bernd-ulmann/gamma_spectrometer/arduino_adc_interface/README.md

# Arduino based ADC interface
There are quite some professional NIM analog-digital-converters out there which
can be used for hobbyist gamma spectroscopy. The only problem being how to 
interface these devices as they often feature a proprietary interface.

A few weeks ago I got a Nuclear Data ND580 ADC which in fact came from a 
gamma spectroscopy setup. After some research it turned out that many of these 
ADCs seem to use a similar parallel interface. The various data and control
lines are available at a double row pin header within the ADC module and often 
also on a 25 pin SUB-D connector. (Some systems such as the Canberra 1510 only 
feature this 25 pin connector.)

# Interface description
This is how a typical classic ADC for gamma spectroscopy looks like. The flat
ribbon cable connects to the double row pin header on the upper right and 
features a 25 pin SUB-D connector which typically connects to some memory 
unit or computer interface.
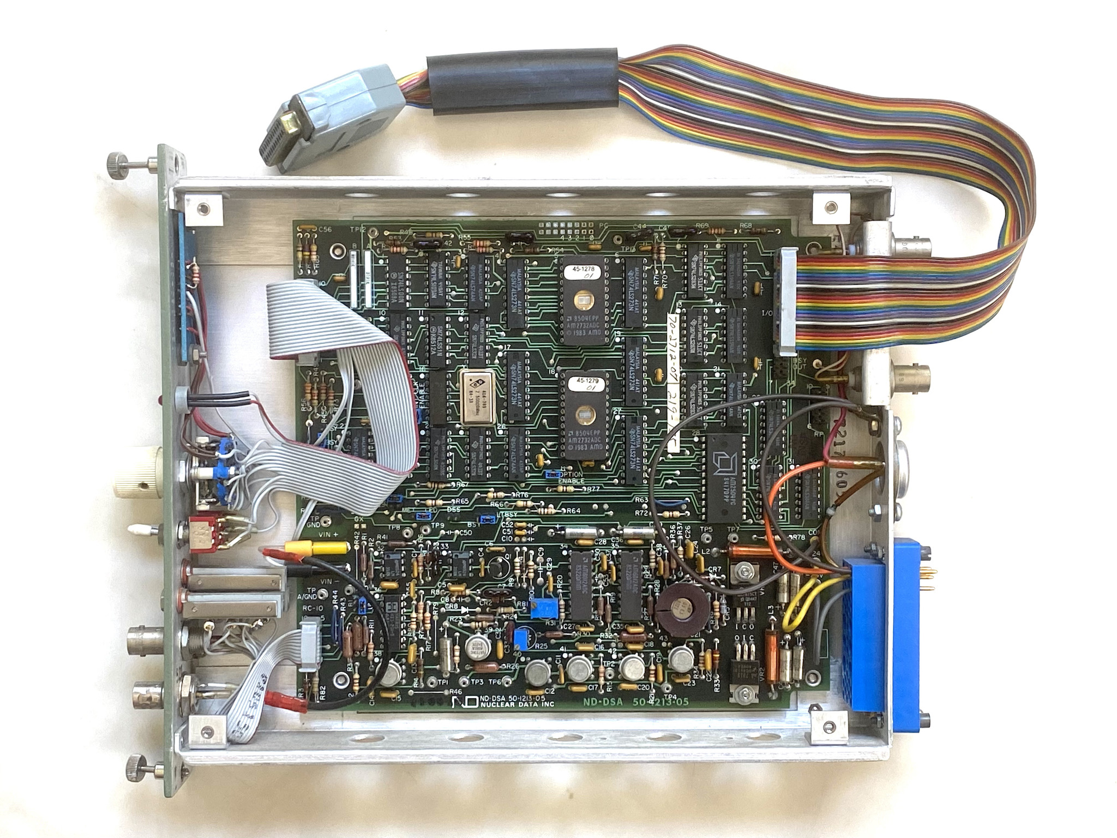
[picture p11: arduino_adc_interface/ADC.jpg]
Interface connector


Thanks to some friends I was able to deduce how this interface works. It is
quite simple, featuring up to 13 data lines (my ND580 ADC only has 4k of 
resolution and thus only drives twelve data lines) and a couple of control and 
handshake lines.

|Arduino port|Function|In/Out|SUB-D pin|Pinheader inside ADC|
|---|---|---|---|---|
|PA0 |D0* |IN |1 |14|
|PA1 |D1* |IN |2 |16|
|PA2 |D2* |IN |3 |18|
|PA3 |D3* |IN |4 |20|
|PA4 |D4* |IN |5 |22|
|PA5 |D5* |IN |6 |24|
|PA6 |D6* |IN |7 |26|
|PA7 |D7* |IN |8 |15|
|PC0 |D8* |IN |9 |17|
|PC1 |D9* |IN |10 |19|
|PC2 |D10* |IN |11 |21|
|PC3 |D11* |IN |12 |23|
|PC4 |D12* |IN |13 |25|
|PC5 |Inhibit*  |IN |20 |12|
|TXD1  |READY* |IN |14 |10|
|PB0 |ACCEPT* |OUT |17 |2|
|GND |ENABLE* | |18 |8|
|GND |OUT ENA*  | |22 |4|
|GND |GND | |24 |1, 3, 5, 7, 9, 11|

All of the interface signals are active low logic, denoted by the star behind 
the signal names. 

* D0 to D12 are the data lines from the ADC. 
* Inhibit can be set by the ADC to denote that a value should be discarded 
  (this signal is ignored in the interface described here).
* READY tells the interface that a new data words is available.
* ACCEPT tells the ADC that the data word has been read.
* ENABLE enables the ADC.
* OUT ENA enables the data lines which are otherwise in high-Z-mode (tri state).

The leftmost column in the table above lists the I/O-pins on the Arduino 
MEGA-2650 which I used in this project. Since the MEGA-2650 only has 8k bytes
of RAM of which a tiny amount is used for program variables, only 2048 channels
of a gamma spectrogram can be stored (at least at 16 bit counter resolution per
channel), so this interface only uses eleven of the twelve data lines, and the 
ADC should be set to 2k conversion gain.

# Arduino code
The C++ code [adc_readout/adc_readout.ino](adc_readout/adc_readout.ino) for the 
Arduino is quite simple and straightforward.
```
/*
    This program controls a Mega 2650 board connected to a Nuclear Data ND580 ADC.
    The purpose is to setup a simple gamma spectroscopy system consisting of old
    NIM modules and this readout module.

    Port mapping (signals marked with '*' are active low):

    IO    Function  Dir.  SUBD  Pinheader inside ADC
    ------------------------------------------------
    PA0   D0*       IN    1     14
    PA1   D1*       IN    2     16
    PA2   D2*       IN    3     18
    PA3   D3*       IN    4     20
    PA4   D4*       IN    5     22
    PA5   D5*       IN    6     24
    PA6   D6*       IN    7     26
    PA7   D7*       IN    8     15
    PC0   D8*       IN    9     17
    PC1   D9*       IN    10    19
    PC2   D10*      IN    11    21
    PC3   D11*      IN    12    23
    PC4   D12*      IN    13    25
    PC5   Inhibit*  IN    20    12
    TXD1  READY*    IN    14    10
    PB0   ACCEPT*   OUT   17    2
    GND   ENABLE*         18    8
    GND   OUT ENA*        22    4
    GND   GND             24    1, 3, 5, 7, 9, 11

    05-APR-2022 B. Ulmann Initial implementation
    08-APR-2022 B. Ulmann Added maximum output in 'c'-command
    03-SEP-2023 B. Ulmann Added X/Y-output for an oscilloscope
    29-SEP-2024 B. Ulmann Added #define to reverse x-deflection voltage.
                          This became necessary since the "new" Telequipment
                          oscilloscope has a weird EXT-X input.
*/

#define BAUD_RATE 115200
#define READY_PIN 18
#define INT_MODE  FALLING
#define ADC_BITS  11        // 2k resolution - we don't have enough RAM for 12 bits resolution :-(

#define X_PIN 13            // PWM outputs for X and Y oscilloscope inputs.
#define Y_PIN 4
#define PIXEL_DELAY 80      // Delay after plotting a pixel to get a more stable display.
#define REVERSE_X TRUE

/*  The X/Y display requires two RC combinations connected to pins 13 and 4 of the 
 * MEGA 2650 board. 4k7 and 100 nF are suggested to get a relatively stable display
 */

union {
  byte raw[2];
  uint16_t value;
} data;

uint16_t counters[1 << ADC_BITS];
uint32_t events = 0, maximum = 0;

void get_data() {
  byte low_byte, high_byte;
  
  detachInterrupt(digitalPinToInterrupt(READY_PIN));

  data.raw[0] = PINA;
  data.raw[1] = PINC & B00111111;

  uint16_t address = ~data.value & 0x0FFF;

  if (counters[address] != 65535)
    if (++counters[address] > maximum)
      maximum = counters[address];

  events++;

  if (!(events % 10000))  // Print a dot every 10000 values to show its alive
    Serial.print(".");
  
  PORTB = B00000000;  // Flip ACCEPT*
  PORTB = B00000001;

  attachInterrupt(digitalPinToInterrupt(READY_PIN), get_data, INT_MODE);
}

void setup() {
  DDRA = B00000000;   // Lower eight bits
  DDRB = B00000001;   // PB0 is an output
  DDRC = B00000000;   // Upper five bits + inhibit

  PORTB = B00000001;  // Deactivate ACCEPT*

  Serial.begin(BAUD_RATE);

  pinMode(X_PIN, OUTPUT);
  pinMode(Y_PIN, OUTPUT);
  TCCR0B = (TCCR0B & 0b11111000) | 0x01;  // No clock divider for timer 0 to get a high PWM frequency

  attachInterrupt(digitalPinToInterrupt(READY_PIN), get_data, INT_MODE);

  Serial.print("INIT...\n");
}

void loop() {
  unsigned int x = 0, y_scale = 0;

  for (;;) {
#ifdef REVERSE_X
    analogWrite(X_PIN, 255 - x);
#else
    analogWrite(X_PIN, x);
#endif
    analogWrite(Y_PIN, counters[x++ << 3] >> y_scale);

    delayMicroseconds(PIXEL_DELAY);
    if (x == 256) {
      x = 0;
      analogWrite(X_PIN, x);

      delayMicroseconds(1000);  // Wait pretty long for the beam to get back to the lower left corner.

      int flag = 0;             // Do we need to rescale the display?
      for (unsigned int i = 0; i < 256; i++)
        if ((counters[i << 3] >> y_scale) > 255)
          flag = 1;

      if (flag) y_scale++;      // Scale by another factor of 2.
    }

    if (Serial.available() > 0) {
      switch(Serial.read()) {
        case 'c': // Read counter
          detachInterrupt(digitalPinToInterrupt(READY_PIN));
          Serial.print("Events = " + String(events) + ", maximum value = " + String(maximum) + "\n");
          attachInterrupt(digitalPinToInterrupt(READY_PIN), get_data, INT_MODE);
          break;
        case 'r': // Readout
          detachInterrupt(digitalPinToInterrupt(READY_PIN));
          Serial.print("--------\n");
          for (uint16_t i = 0; i < (1 << ADC_BITS); Serial.print(String(counters[i++]) + "\n"));
          Serial.print("--------\n");
          attachInterrupt(digitalPinToInterrupt(READY_PIN), get_data, INT_MODE);
          break;
        case 'x': // Reset
          detachInterrupt(digitalPinToInterrupt(READY_PIN));
          events = maximum = y_scale = 0;
          for (uint16_t i = 0; i < (1 << ADC_BITS); counters[i++] = 0);
          Serial.print("Reset\n");
          attachInterrupt(digitalPinToInterrupt(READY_PIN), get_data, INT_MODE);
          break;        
      }
    }
  }
}
```

At the heart of the software is the interrupt routine get_data() which is 
called whenever the READY line has a falling edge. It reads an eleven bit 
data word into a union which effectively combines the two parts of this word
into a single 16 bit value, the channel number. It then increments the 
respective channel counter. It also counts the overall number of events 
detected to far and the maximum count number of all channels.

This little program communicates with an attached computer by means of the 
builtin USB interface employing a serial-line emulation. Three commands are
supported: 

* c: Return the number of overall events counted so far as well as the maximum
     peak in all channels.
* r: Read data from the 2048 channels. Data is returned as 2048 lines each 
     containing the number of events in a channel in decimal representation.
* x: Reset the device, i.e. clear all channel counters etc.

By default Arduinos perform a reset when a new serial line connection is 
established, which is quite undesirable in an application like this with 
long measurement times. It is advisable to cut the "reset" bridge on the 
Arduino board (see documentation for the MEGA-2650). Since this reset feature
is important for the programmability of the Arduino, a switch should be 
connected to this cut bridge connection (this is the switch labelled "run/prg").

The following pictures show the exterior of the interface and its construction:
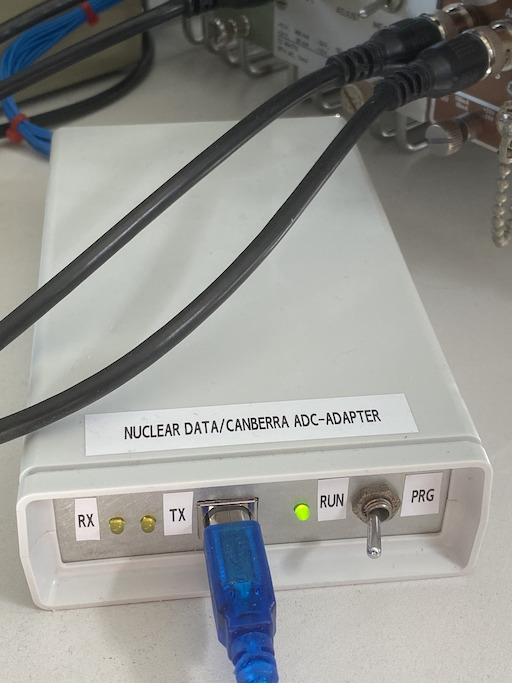
[picture p12: arduino_adc_interface/interface.jpg]
Interface

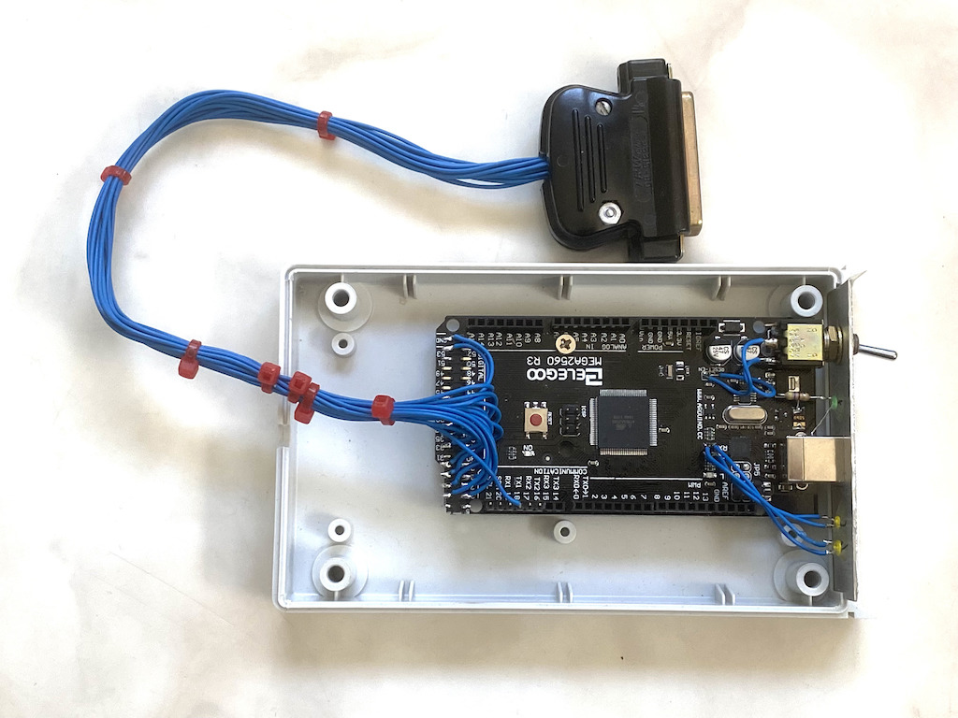
[picture p13: arduino_adc_interface/interior_view.jpg]
Interior view


# Readout and display software
Although it is possible and feasible to use this interface manually using the
serial monitor which is part of the Arduino IDE, copying the channel counts 
into a file and then using gnuplot or a similar tool to display the data, it
is more convenient to use a little tool written in Perl to communicate with 
the ADC interface: [adcread.pl](adcread.pl)

```
#
#  This simple Perl program either reads raw data from the Arduino based ADC
# adapter which works with Nuclear Data ADCs such as the ND580 or with 
# similar Canberra devices like the Canberra 1510.
#
#  This program can perform a number of actions as described in the help 
# message below.
#
#  Data is displayed using gnuplot. The plot is not normalized with respect to
# its x- and y-axes, so that energy calibration must be done using the -e 
# parameter. 
#
# 2022-04-09    B. Ulmann   Initial version based on the old Perl program 
#                           targeted at the homebrew simple Gamma spectrometer.
# 2022-04-13    B. Ulmann   Added keV-scaling.
# 2023-03-19    B. Ulmann   Added JPG output
# 2026-07-25    B. Ulmann   Added denser xtics and log scale
#

use strict;
use warnings;
use File::Temp;
use Getopt::Long qw(GetOptions);
use Device::SerialPort;
use Time::HiRes qw(usleep);
use POSIX qw(strftime);

my $baudrate = 115200;
my $channels = 2048;

die "Usage: perl $0 {-u <usb_port> | -f <filename>} 
                    [-w <window_size>] 
                    [-f <filename>] Reads data from a file
                    [-e <energy of last channel]
                    [-d <destination_filename>] Timestamp by default
                    [-t <title>]
                    [-l] set y axis to log scale
                    [-p] generate a plot
                    [-j] do not plot but create a jpg picture
                    [-a] alpha spectrum (different parameters)
                    [-y <value>] set y-range
       perl $0 -r (to reset the device)
       perl $0 -s (to get statistics)\n" 
    unless @ARGV;

my ($usb_port, $window_size, $filename, $destination, $statistics, $reset, 
    $title, $jpg, $plot, $yrange, $alpha, $logscale, $energy);
$title = '';
GetOptions('u=s' => \$usb_port, 
           'w=s' => \$window_size, 
           'f=s' => \$filename, 
           'd=s' => \$destination, 
           's'   => \$statistics, 
           'r'   => \$reset,
           'j'   => \$jpg,
           'p'   => \$plot,
           'a'   => \$alpha,
           'l'   => \$logscale,
           'e=s' => \$energy,
           'y=s' => \$yrange,
           't=s' => \$title);

die "Either -f or -u must be specified!\n" if !defined($filename) and !defined($usb_port);
die "-f and -u are mutually exclusive!\n"  if  defined($filename) and  defined($usb_port);

my $port;
if (defined($usb_port)) {
    $port = Device::SerialPort->new($usb_port) or die "Unable to open USB-port: $!\n";
    $port->baudrate($baudrate);
    $port->databits(8);
    $port->parity('none');
    $port->stopbits(1);
}

my $date = strftime("%Y%m%d-%H%M%S", localtime);
$title |= "$date";
$title = $filename if defined($filename);

if ($reset) {
    die "Reset requires a USB port to be specified!\n" unless defined($port);
    $port->write('x');  # Send reset command
    sleep(1);
    my $response = $port->lookfor();
    die "Illegal response from device: >>$response<<\n" unless $response =~ ".*Reset";
    print "Device has been reset.\n";
} elsif ($statistics) {
    die "Statistics requires a USB port to be specified!\n" unless defined($port);
    $port->write('c');  # Send reset command
    sleep(1);
    my $response = $port->lookfor();
    print "$response\n";
} else {
    my @data;
    if (defined($filename)) {
        open (my $handle, '<', $filename) or die "Could not open $filename: $!\n";
        while (my $record = <$handle>) {
            chomp($record);
            push(@data, $record) if $record =~ /^\d+$/;
        }
        close($handle);
    } else {
        print "Read data...\n";
        $port->write('r');  # Issue 'read' command to gamma spectrometer
        sleep(1);

        my $state = 0;
        for my $i (0 .. 3000) {
            usleep(100);
            my $response = $port->lookfor();
            last       if $response =~ /-+/ and $state == 1; # End of data area found
            $state = 1 if $response =~ /-+/ and $state == 0; # Start of data area found

            push(@data, $response) if $response =~ /^\d+/;
        }
    }
    print scalar(@data), " records read.\n";

    my $handle;
    unless (defined($filename)) {
        $destination //= "$date.dat";
        print "Saving raw data to $destination.\n";
        open($handle, '>', $destination) or die "Could not open $destination: $!\n";
        print $handle "$_\n" for @data;
        close($handle);
    }

    if ($plot or $jpg) {
        my ($counts, @smoothed);
        if (defined($window_size)) {
            print "Smoothing with window size $window_size.\n";
            my @window;
            push(@window, shift(@data)) for (1 .. $window_size);
            $counts += $_ for @window;
            for my $i (0 .. @data - 1) {
                my $average;
                $average += $_ for @window;
                push(@smoothed, $average / $window_size);
                shift(@window);
                $counts += $data[$i];
                push(@window, $data[$i]);
            }
        } else {
            @smoothed = @data;
            $counts += $_ for @data;
            print "No smoothing applied.\n";
        }
        print "$counts events detected.\n";

        my ($increment, $x_label, $x_range);
        if (!defined($energy)) {
            $x_label = 'Channel #';
            $increment = 1;
            $x_range = $channels;
        } else {
            $increment = $energy / $channels;
            $x_label = 'Energy [keV]';
            $x_range = $energy;
        }

        $handle = File::Temp->new();
        my $tempfile = $handle->filename();
        my $x = 0;
        print $handle $x += $increment, " $_\n" for @smoothed;
        close($handle);

        my $command;
        my $y = $yrange   ? "set yrange [0:$yrange]; " : '';
        my $l = $logscale ? 'set logscale y 10; '      : '';
        
        # If the gnuplot command ends with '-' gnuplot will not be terminated 
        # after generating the plot.

        if ($jpg) {
            $command = qq(gnuplot -e "set terminal jpeg; set output '$date.jpg'; $y set xrange [0:$x_range]; set title '$title'; set xlabel '$x_label'; set ylabel 'Counts'; set xtics 0, 100; set xtics rotate by 90; $l plot '$tempfile' notitle w l");
        } else {
            $command = qq(gnuplot -e "$y set xrange [0:$x_range]; set title '$title'; set xlabel '$x_label'; set ylabel 'Counts'; set xtics 0, 100; set xtics rotate by 90; $l plot '$tempfile' notitle w l");
        }
        system($command);
    }
}
```

# Setup and usage
This was my first setup:
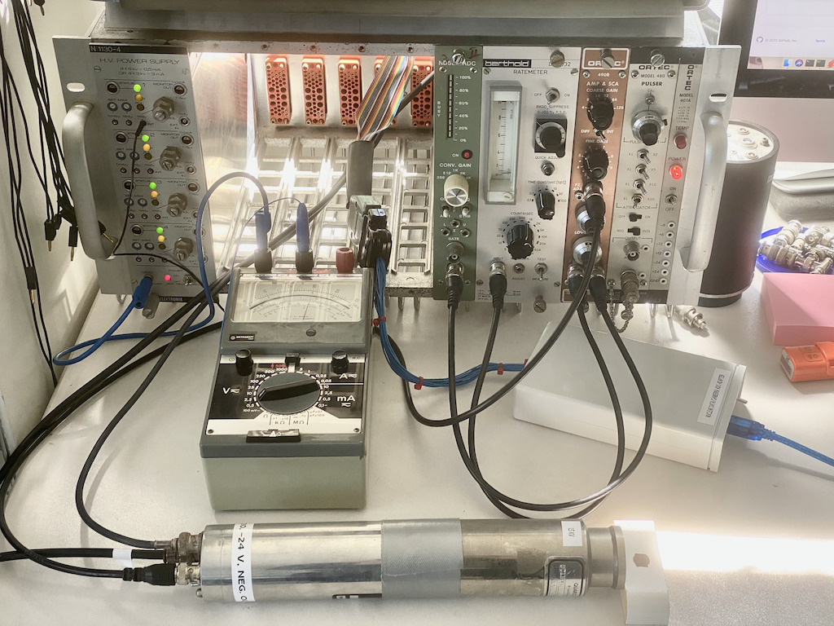
[picture p14: arduino_adc_interface/setup.jpg]
Setup


It consisted (from left to right) of an ORTEC NIM crate with a high voltage 
power supply for the photomultiplier tube, the Nuclear Data ND580 ADC, a 
Berthold ratemeter, an ORTEC model 490B amplifier and an ORTEC model 480 
pulser which was quite useful for debugging and calibrating the setup.

The voltmeter is used to set the high voltage (the high voltage power supply
yields a monitor voltage at 1 V/kV). In front of this, the photomultiplier
assembly can be seen. The Arduino based ADC adapter is the little white box
on the right.

To record and display a spectrum, the adapter first has to be reset (the 
USB device is only valid for my setup as it depends on the actual Arduino
board):
```
➜  arduino perl adcread.pl -u /dev/cu.usbmodem146301 -r
Device has been reset.
```

After the desired measurement time, data can be read, displayed (and optionally
smoothed for display and stored (unaltered) in a file) like this:
```
➜  arduino perl adcread.pl -u /dev/cu.usbmodem146301 -d spectrum.dat -w 10
Read data...
2048 records read.
Saving raw data to spectrum.dat.
Smoothing with window size 10.
383154 events detected.
gnuplot> 
```

The program will leave the user at the gnuplot prompt so that the graphic can
be exported to various file formats, scales can be adapted etc.

The output from the command above looks like this (the source was my 
grandmother's old clock which contains only traces of Ra226, so the measurement
times are quite long):
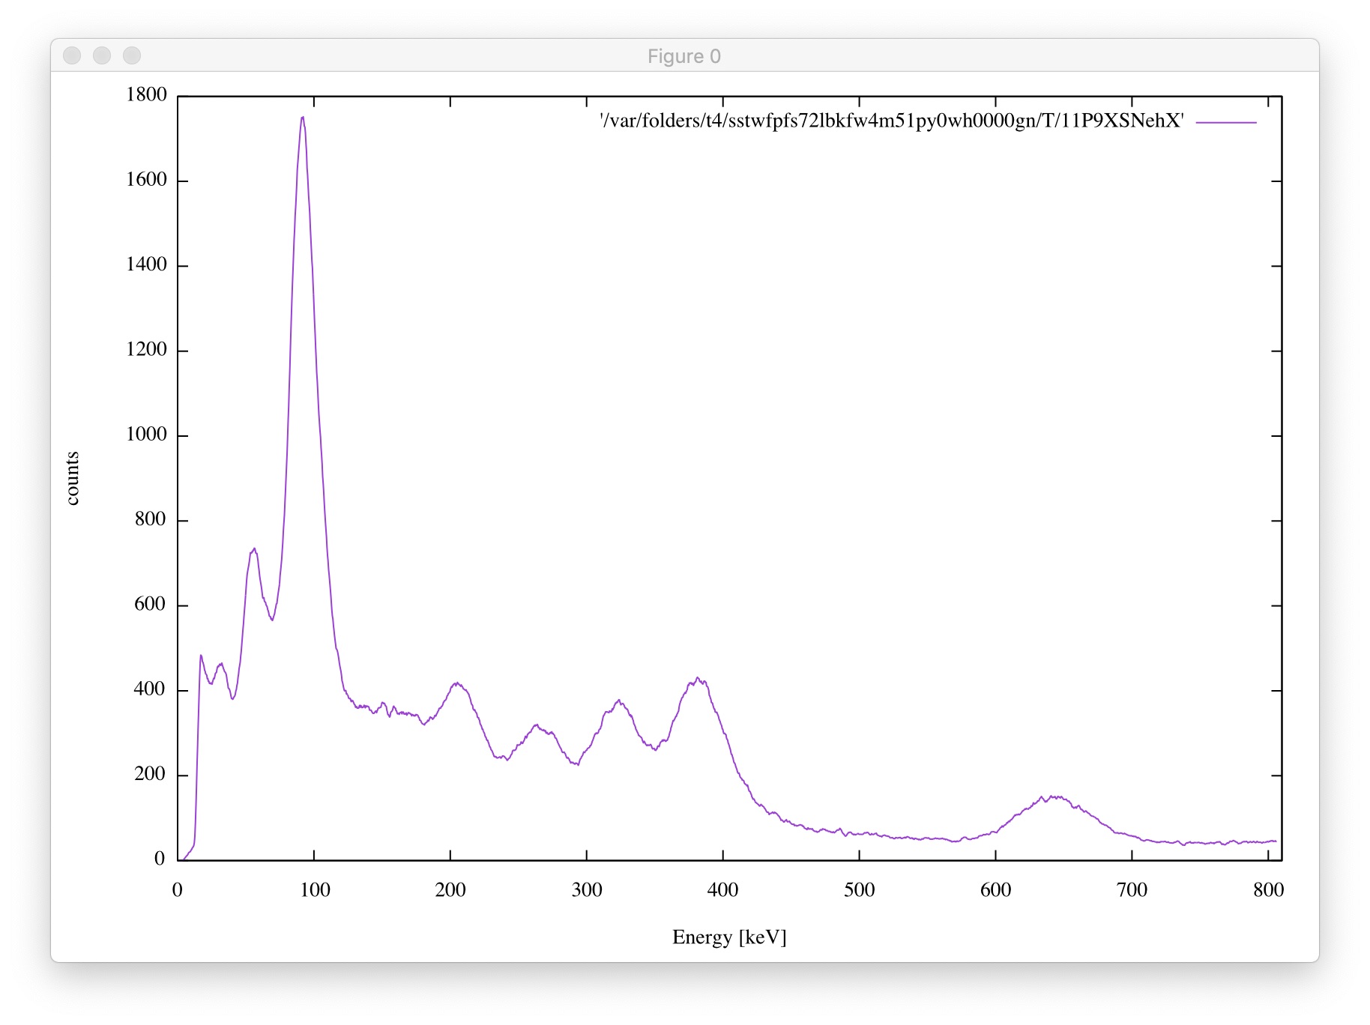
[picture p15: arduino_adc_interface/spectrum.jpg]


# XY-output (September 2023)

The current firmware for the Arduino MEGA2650 now also supports analog X- and
Y-outputs to drive an oscilloscope or X/Y-display. This is a really useful 
feature as it allows one to tinker with the settings of the various parts of 
the Gamma spectrometer and directly observe the effects without requiring a
computer reading and displaying values.

These two control voltages are derived by a simple RC-combination for each
channel (4k7 in series with a BNC output socket and a 100 nF capacitor from the BNC socket's signal pin to ground) connected to the PWM outputs on pins 4 and
13 of the MEGA2650. 

To achieve a high output signal frequency, the PWM base frequency must be 
increased substantially over the standard frequency of 490 Hz. This is done
by configuring the Timer 0 to work with a lower divider value.

The following picture shows a typical setup:
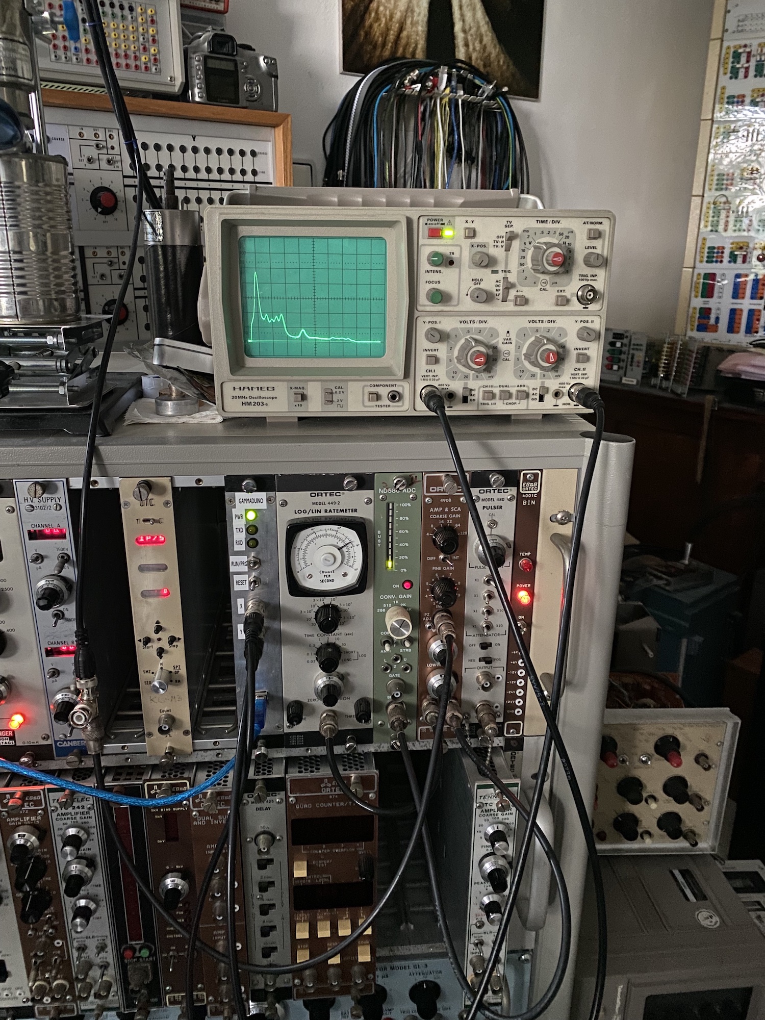
[picture p16: arduino_adc_interface/NIMsetup.jpg]


The oscilloscope is run in X/Y-mode (at first glance it would be much simpler
to just generate a repeating output signal with a leading trigger signal but
the stochastic nature of the interrupts caused by the attached ADC makes this
impossible as it yields a very jittery display) and shows a typical RA226
Gamma spectrum. 

To fit into the surrounding NIM environment, the Arduino has been mounted in 
an empty NIM enclosure:
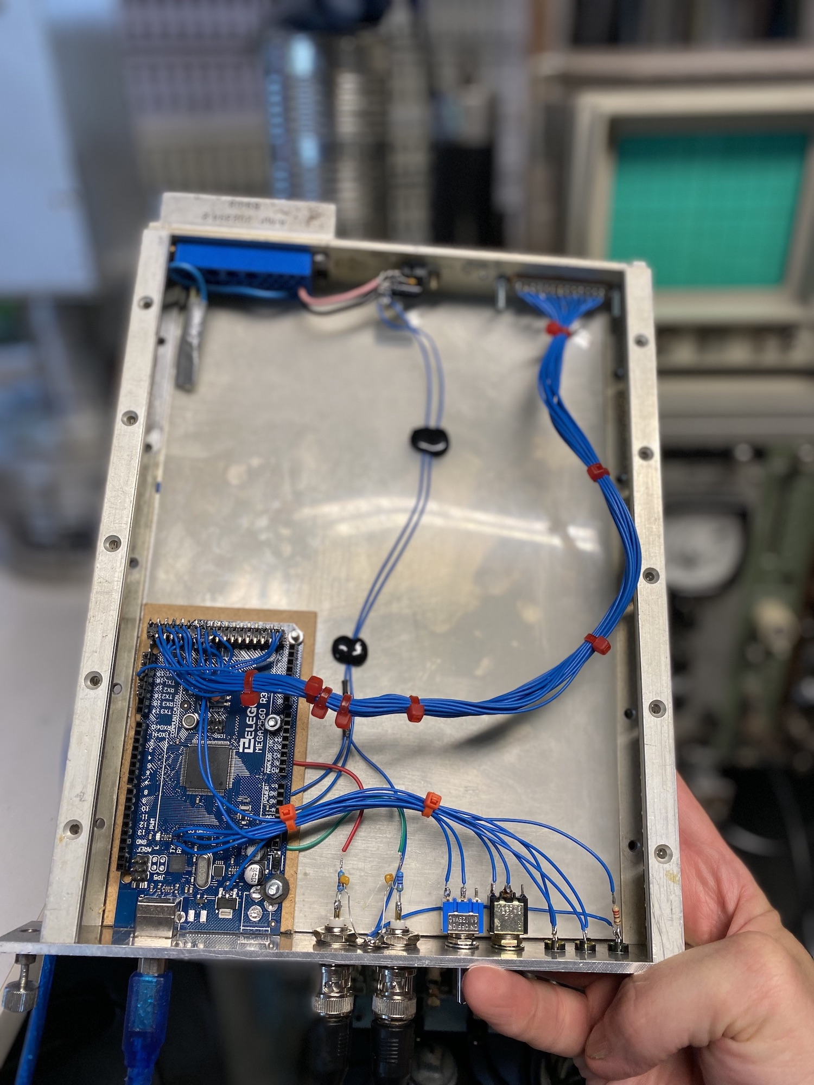
[picture p17: arduino_adc_interface/gammaduino_internal.jpg]


The following picture shows the "Gammaduino" NIM module mounted in a NIM-chassis
next to an ORTEC LOG/LIN Ratemeter. To the right is the central ND580 ADC and
an ORTEC 490B amplifier connected to the photomultiplier base:
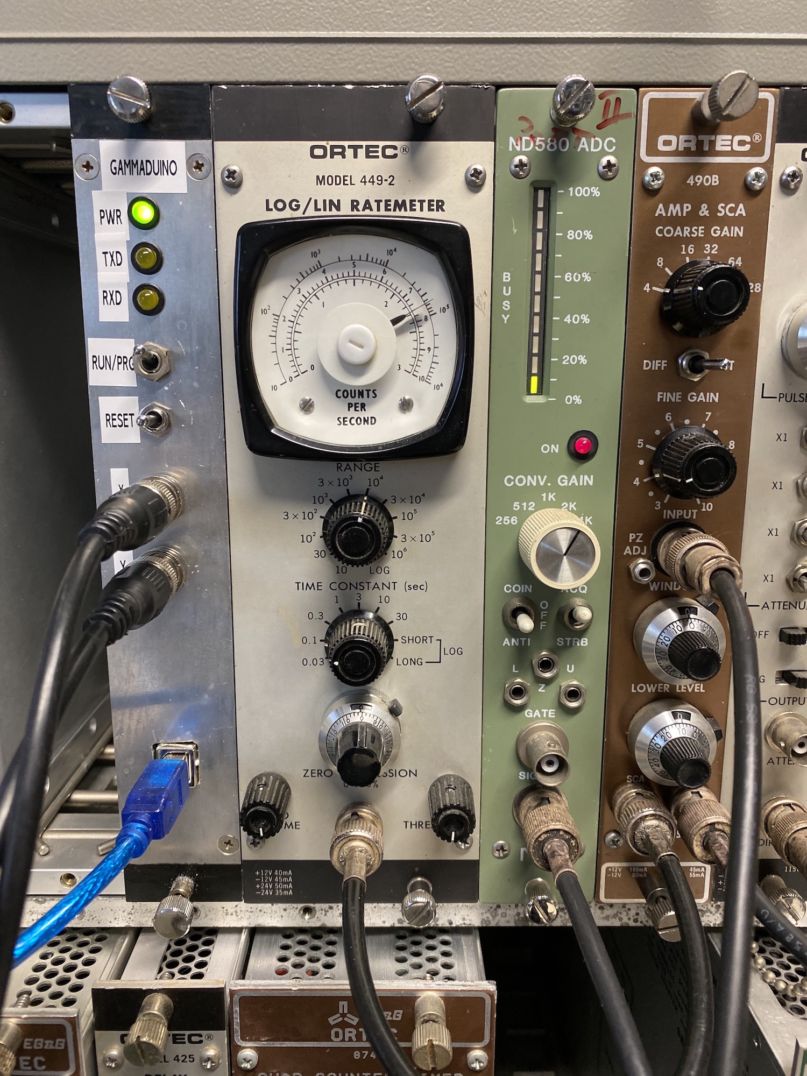
[picture p18: arduino_adc_interface/gammaduino_in_chassis.jpg]


# New setup (July 2026)

Over the last few years my setup grew more and more (as hobby projects tend 
to do). The current system looks like this:
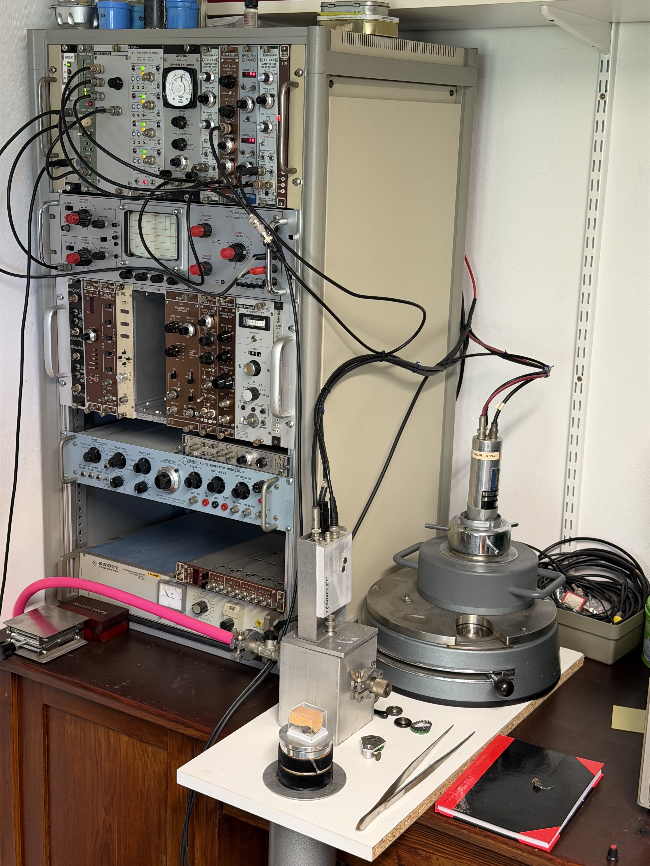
[picture p19: arduino_adc_interface/setup2026.jpg]


All of the amplifiers, high (and not so high) voltage supplies, ADC, homebrew
modules, etc., are housed in two NIM crates mounted in the rack on the left. 
In between is a classic Telequipment oscilloscope which is typically used in 
X/Y mode to display spectra. The bluish/gray device near the bottom is a pulse
generator to test the overall amplifier/ADC chain.

On the front right is a Frieseke & H&ouml;pfner photomultiplier with attached
bore-hole scintillator. Behind it is my Alpha spectroscopy chamber which can
be evacuated. On top of this is a Tennelec pre-amplifier which is directly
connected to the detector in the vacuum chamber. In the back is a classic 
manual sample changer with an attached PMT with scintillator. 

The object of interest is a small mineral sample I got from my father in law 
who is an avid mineral collector. This is a tiny piece auf Autunit found in 
Bavaria which shows a beautiful spectrum (shown as a log graph):

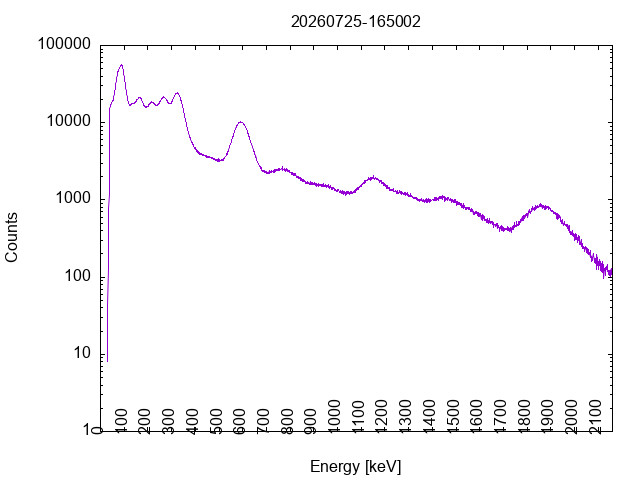
[picture p20: arduino_adc_interface/autunit.jpg]
