bernd-ulmann/gamma_spectrometer/arduino_adc_interface/xy_output.jpg

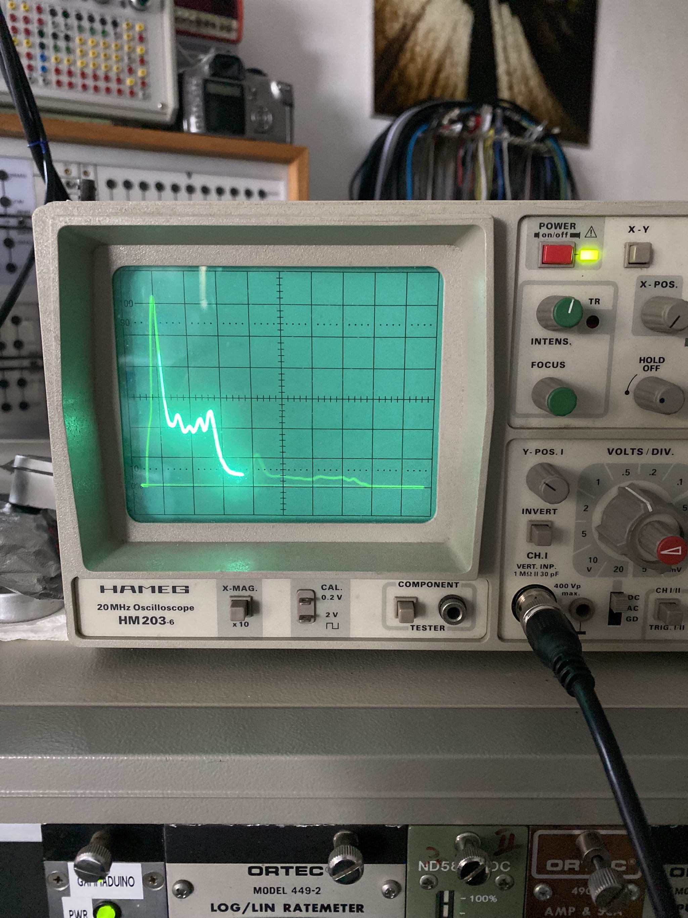
arduino_adc_interface/xy_output.jpg
