bernd-ulmann/gamma_spectrometer/tiny_spectrometer/rft_amplifier.jpg

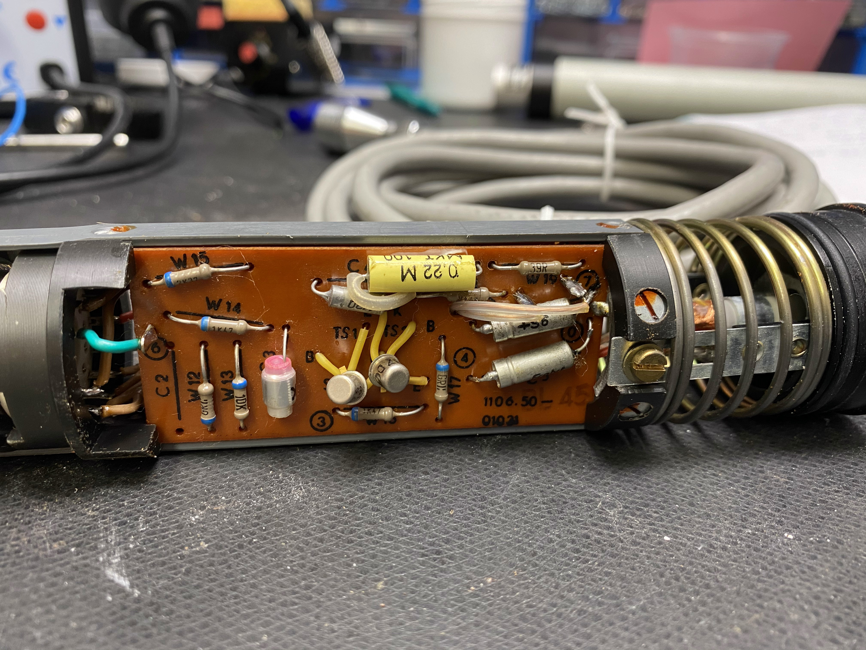
tiny_spectrometer/rft_amplifier.jpg
