bernd-ulmann/gamma_spectrometer/tiny_spectrometer/rft_divider.jpg

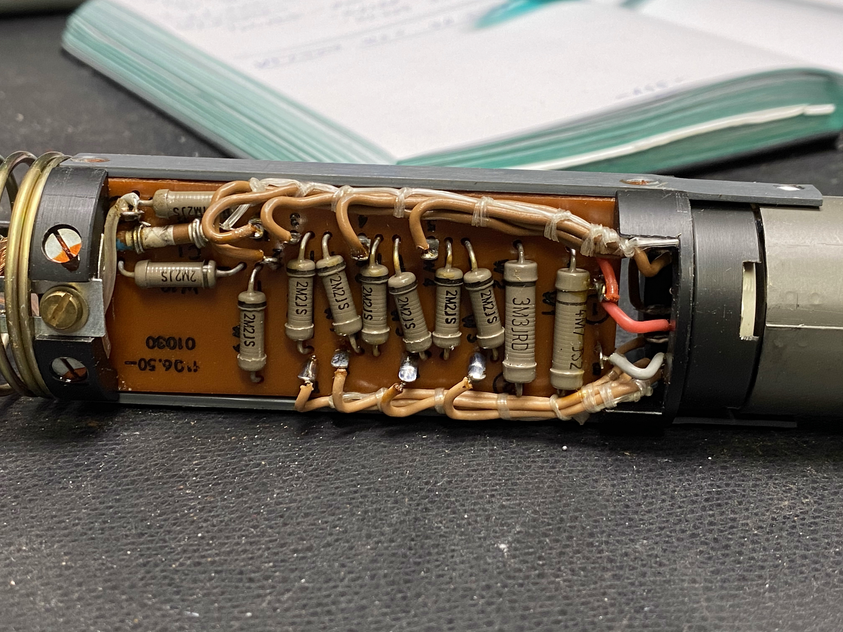
tiny_spectrometer/rft_divider.jpg
