bernd-ulmann/gamma_spectrometer/tiny_spectrometer/analog_frontend.pdf

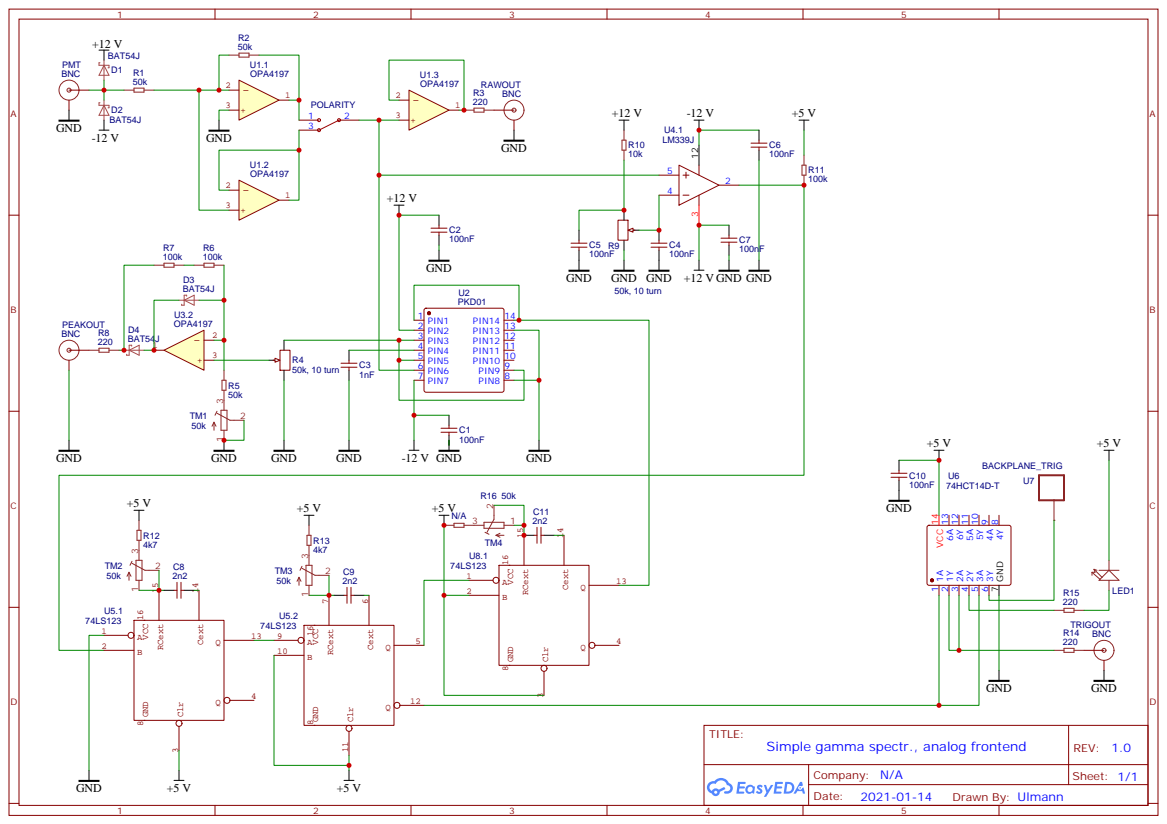
[picture p24: page 1]
