bernd-ulmann/gamma_spectrometer/(commit log)

2021-01-14 Added the schematic of the front end.
2021-01-14 Added picture of the actual circuit.
2021-01-14 Added picture of the Arduino board.
2021-01-14 Added ARDUINO circuit.
2021-01-14 BCD switch description added.
2021-01-21 Changed ADC prescaler settings to 19.2 kSPS which removed most of the noise in the energy spectrum.
    [gamma_spectrometer_arduino.ino]
2021-01-21 Changed ADC to 19.2 kSPS.
2021-09-13 Circuit change to avoid pulse pile up.
2023-09-03 The ADC readout program now supports a real time X/Y display on an attached oscilloscope.
2023-09-16 Updates adread.pl - there is now an optional parameter -e to specify the upper energy limit (in keV). If omitted, the x-axis is labeled in channels, otherwise in keV.
2024-02-18 Previously, reset did not reset the y-scale factor which it does now. :-)
    [adc_readout.ino]
2024-09-29 Added a #define so that the X-output to the oscilloscope can be inverted which is necessary for some Telequipment oscilloscopes. Defining REVERT_X will work for these "strange" instruments. In normal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
    [adc_readout.ino]
2026-07-25 Add files via upload
    Added picture of the current setup.
2026-07-25 Add files via upload
    Sample Gamma spectrum in log mode.
2026-07-25 Update README.md
    Added picture of new setup and a sample Gamma spectrum in log mode.
